A75543/Environmental-and-Personal-Information-Processor/assets/20250226_014021.jpg

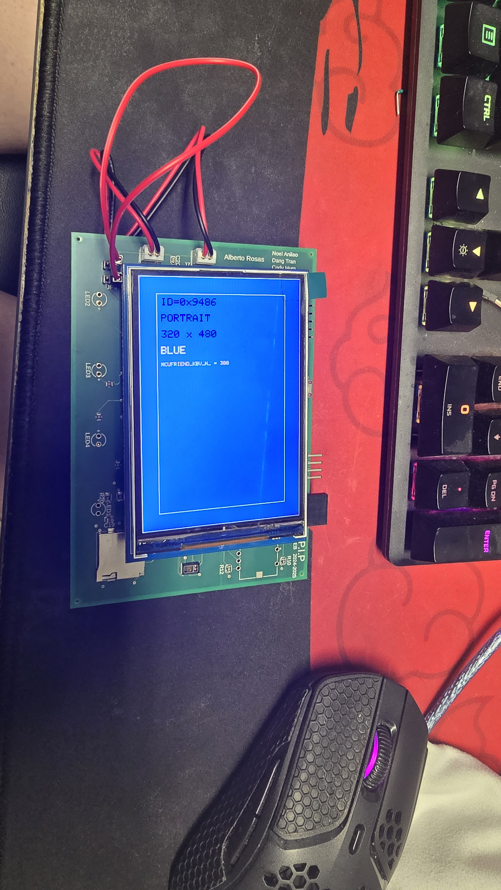
assets/20250226_014021.jpg
