A75543/Environmental-and-Personal-Information-Processor/assets/20250201_014853.jpg

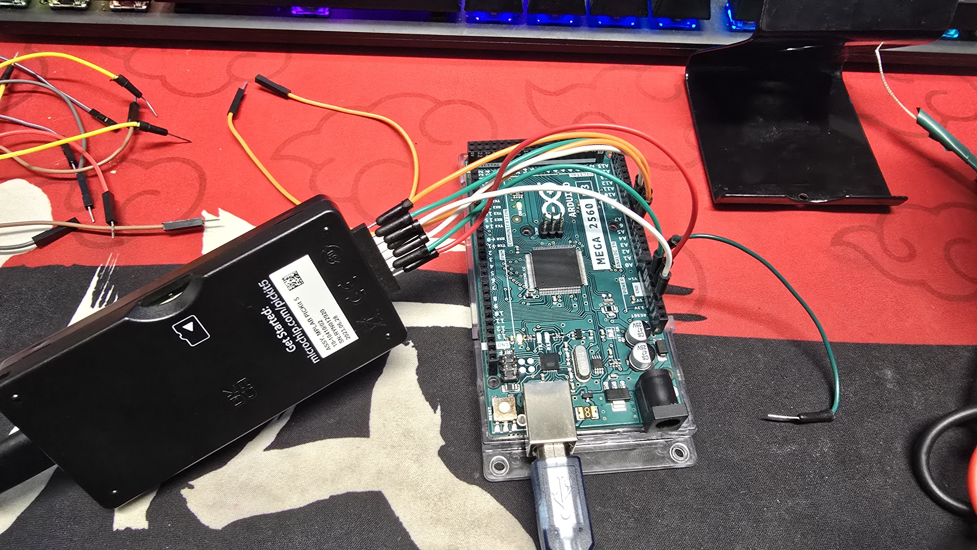
assets/20250201_014853.jpg
