A75543/Environmental-and-Personal-Information-Processor/assets/20250202_034527.jpg

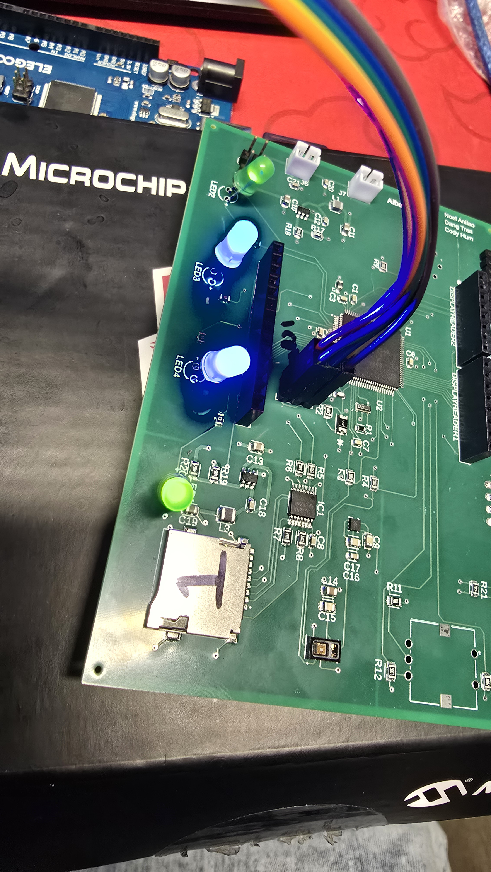
assets/20250202_034527.jpg
