A75543/Environmental-and-Personal-Information-Processor/hardware/EPIP_layout.png

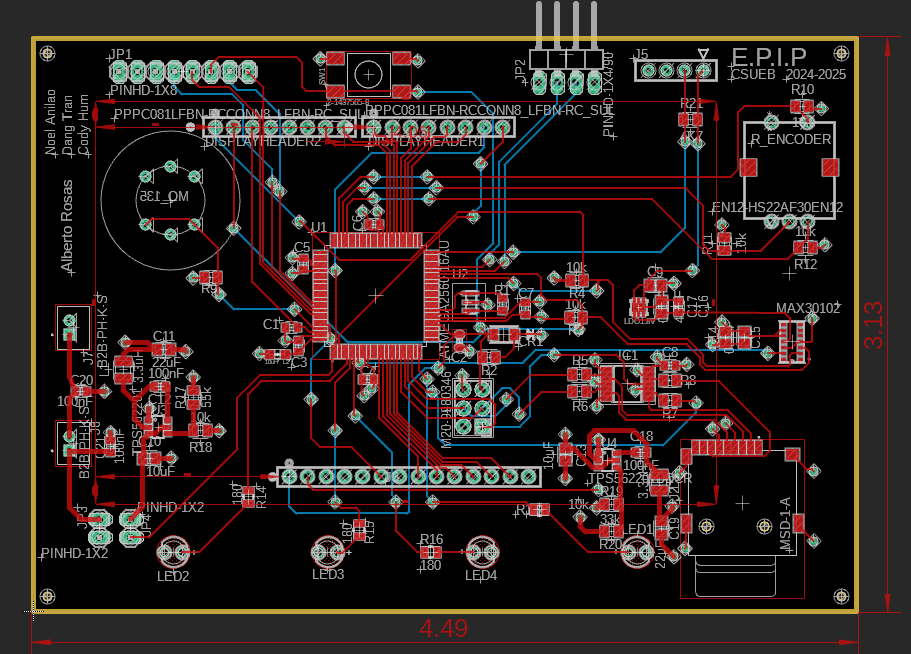
hardware/EPIP_layout.png
