A75543/Environmental-and-Personal-Information-Processor/hardware/EPIP_schem.pdf

CSTNE16M0V530000R0 ¹M | GND GND | GND
100nF | 100nF | 100nF

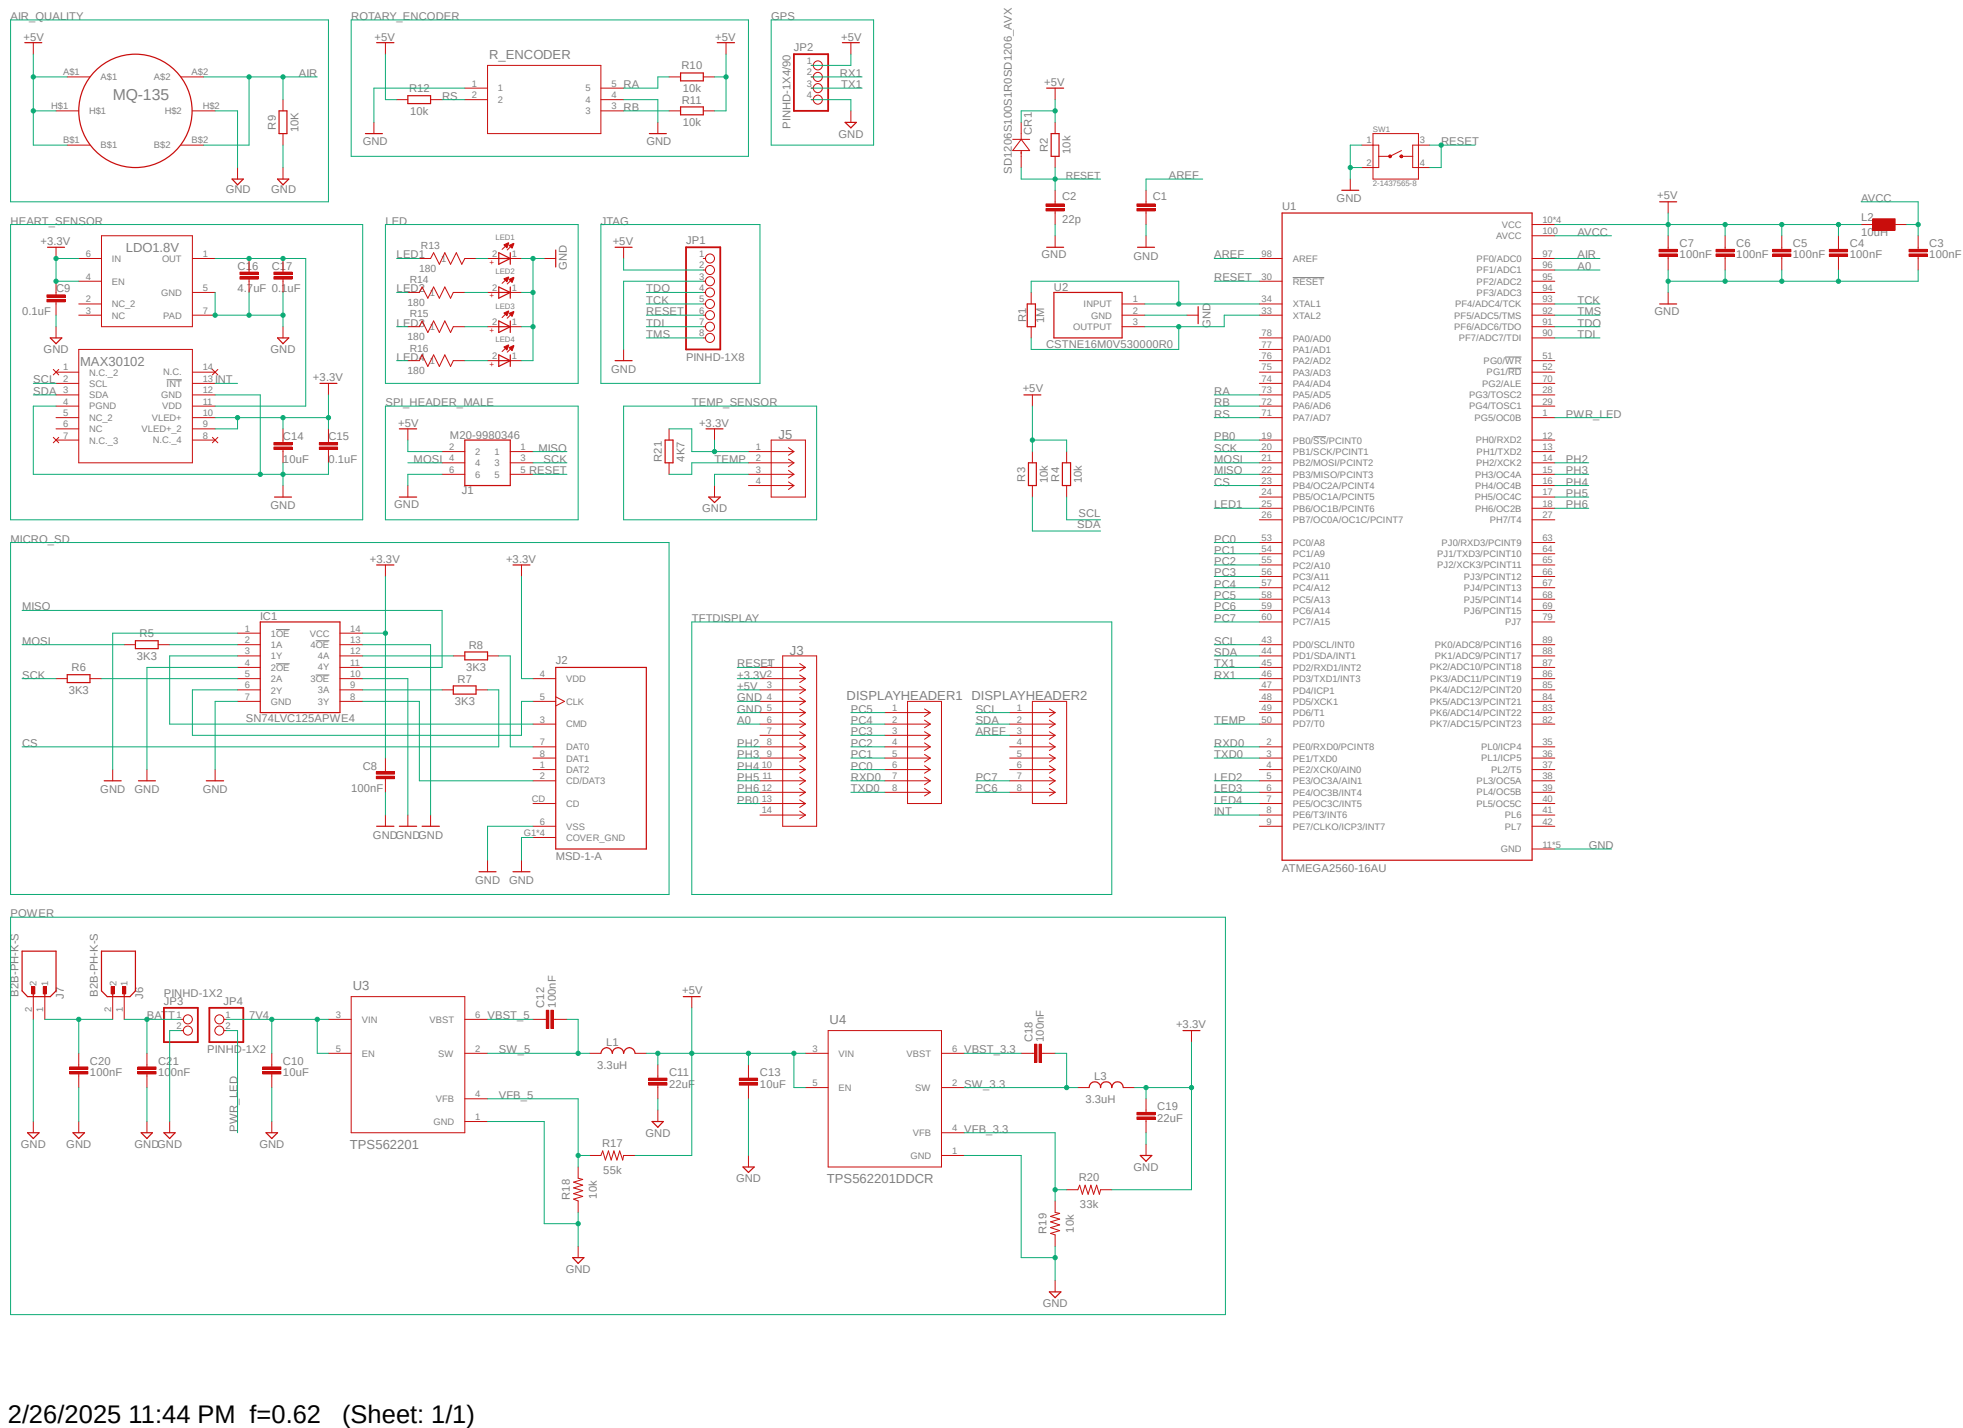
[picture p25: page 1]

2 U3 GND 1 SW 2 VIN 3 VFB 4 EN 5 VBST 6 C10 R17 R18 C11
