A75543/Environmental-and-Personal-Information-Processor/hardware/EPIP_v173.sch

## EAGLE design hardware/EPIP_v173.sch (2025-02-27, last stored version)

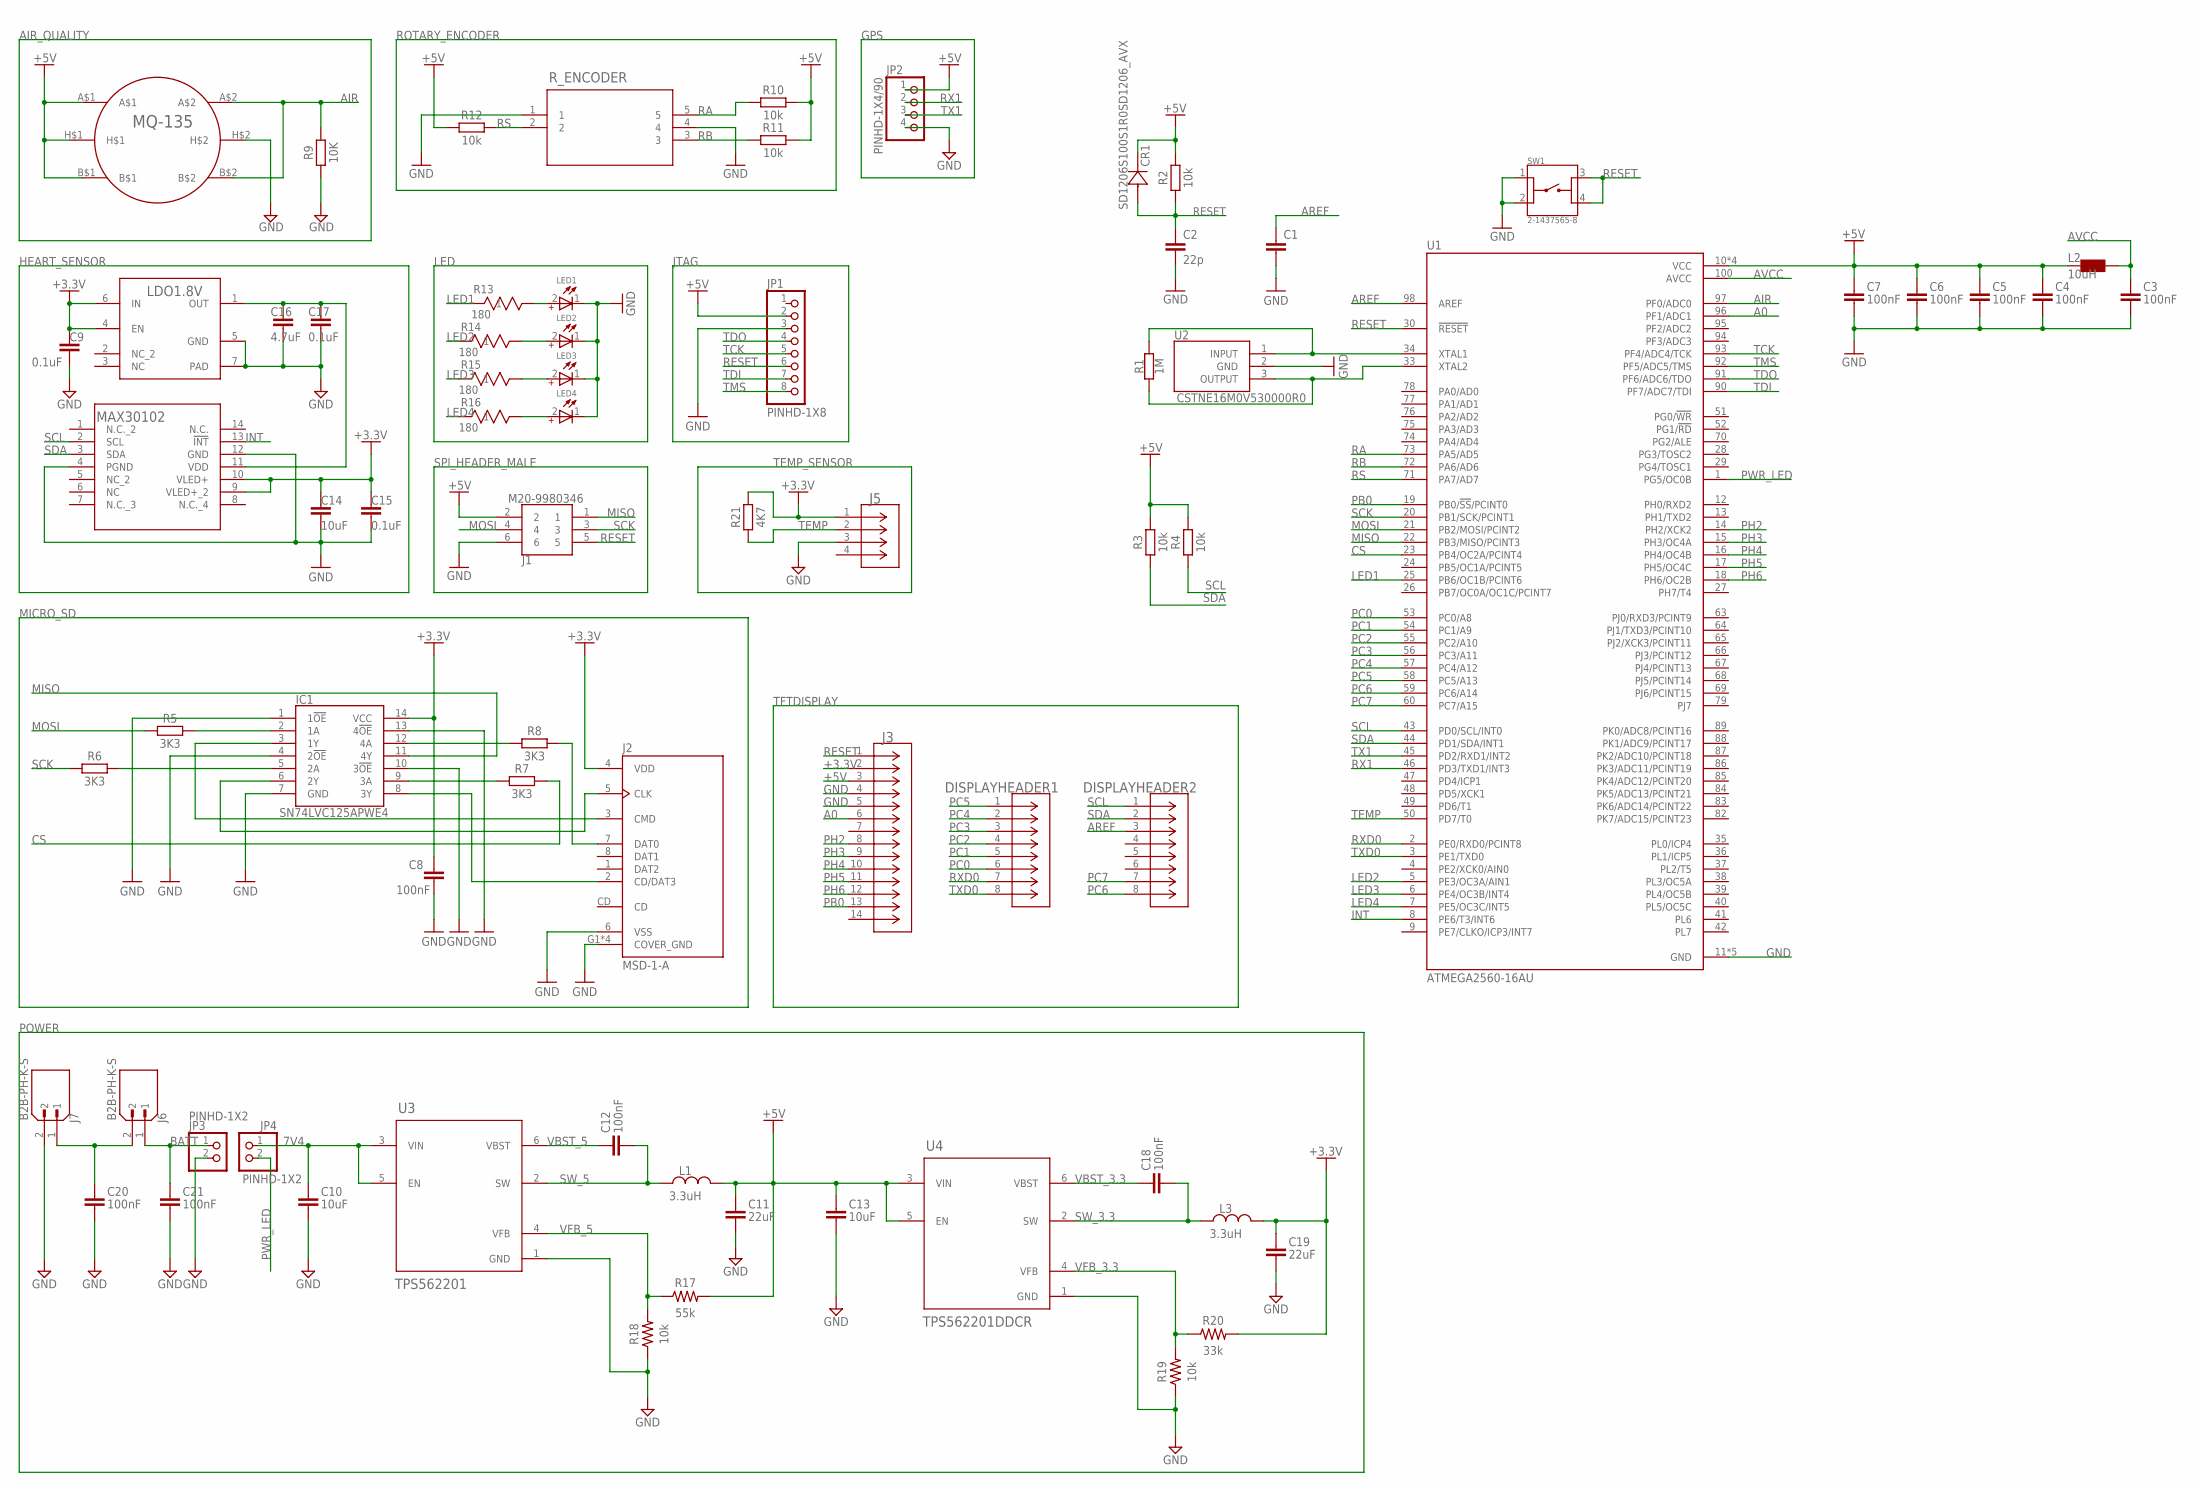
[picture p26: schematic EPIP_v173.sch]

Parts:
C1, C3, C4, C5, C6, C7, C8, C12, C18, C20, C21: 100nF; CAPC1608X85
C2: 22p; C0603-ROUND
C9, C15, C17: 0.1uF; CAPC2012X110
C10, C13, C14: 10uF; CAPC2012X110
C11, C19: 22uF; CAPC2012X110
C16: 4.7uF; CAPC1608X85
CR1: SD1206S100S1R0SD1206_AVX; SD1206_AVX
DISPLAYHEADER1, DISPLAYHEADER2: PPPC081LFBN-RCCONN8_LFBN-RC_SUL; CONN8_LFBN-RC_SUL
IC1: SN74LVC125APWE4; SOP65P640X120-14N
J1: M20-9980346; HDRV6W64P254_2X3_762X508X868P
J2: MSD-1-A; CUI_MSD-1-A
J3: PPPC141LFBN-RCCONN14_PPPN141_SUL; CONN14_PPPN141_SUL
J5: PPTC041LFBN-RCCONN_PPTC041LFBN-RC_SUL; CONN_PPTC041LFBN-RC_SUL
J6, J7: B2B-PH-K-S; JST_B2B-PH-K-S
JP1: PINHD-1X8; 1X08
JP2: PINHD-1X4/90; 1X04/90
JP3, JP4: PINHD-1X2; 1X02
L1, L3: 3.3uH; INDC2520X120N
L2: 10uH; 0805
LDO1.8V: LP5910-1.8DRVRDRV0006A_NV; DRV0006A_NV
LED1, LED2, LED3, LED4: WL-TMRW_3MM_WITHOUTSTOPPER; WL-TMRW_3MM
MAX30102: MAX30102EFD+T21-1048_F143A5+1_MXM-L; 21-1048_F143A5+1_MXM-L
R1: 1M; RESC1608X60
R2, R3, R4, R10, R11, R12, R18, R19: 10k; RESC2012X65
R5, R6, R7, R8: 3K3; RESC2012X65
R9: 10K; RESC2012X65
R13, R14, R15, R16: 180; STA_RMCF0805_STP-L
R17: 55k; RESC2012X65
R20: 33k; RESC2012X65
R21: 4K7; RESC2012X65
R_ENCODER: EN12-HS22AF30EN12; EN12-HS_TTE
SW1: 2-1437565-8; SW_SMD_2-1437565-8_4_4.50_6.00_6.00_5.00
U1: ATMEGA2560-16AU; QFP50P1600X1600X120-100N
U2: CSTNE16M0V530000R0
U3: TPS562201; DDC0006A_L
U4: TPS562201DDCR; DDC0006A_L
U$2: MQ_135_A; MQ-135

Connections:
7V4: C10.1, JP4.1, U3.3 (VIN), U3.5 (EN)
+3.3V: C8.1, C9.1, C14.1, C15.1, C19.1, IC1.14 (VCC), J2.4 (VDD), J3.2, J5.1, L3.2, LDO1.8V.4 (EN), LDO1.8V.6 (IN), MAX30102.9 (VLED+_2), MAX30102.10 (VLED+), R20.2, R21.2
+5V: C4.1, C5.1, C6.1, C7.1, C11.1, C13.1, CR1.1, J1.2, J3.3, JP1.2, JP2.1, L1.2, L2.2, R2.2, R3.2, R4.2, R10.2, R11.2, R12.1, R17.2, U1.10 (VCC), U4.3 (VIN), U4.5 (EN), U$2.A$1, U$2.B$1, U$2.H$1
A0: J3.6, U1.96 (PF1/ADC1)
AIR: R9.2, U1.97 (PF0/ADC0), U$2.A$2, U$2.B$2
AREF: C1.1, DISPLAYHEADER2.3, U1.98 (AREF)
AVCC: C3.1, L2.1, U1.100 (AVCC)
BATT: C21.1, J6.1, JP3.1
CS: R7.2, U1.23 (PB4/OC2A/PCINT4)
GND: C1.2, C2.2, C3.2, C4.2, C5.2, C6.2, C7.2, C8.2, C9.2, C10.2, C11.2, C13.2, C14.2, C15.2, C16.2, C17.2, C19.2, C20.2, C21.2, IC1.1 (1!OE), IC1.4 (2!OE), IC1.7 (GND), IC1.10 (3!OE), IC1.13 (4!OE), J1.6, J2.6 (VSS), J2.G1 (COVER_GND), J3.4, J3.5, J5.3, J7.2, JP1.3, JP2.4, JP3.2, LDO1.8V.5 (GND), LDO1.8V.7 (PAD), LED1.1 (-), LED2.1 (-), LED3.1 (-), LED4.1 (-), MAX30102.4 (PGND), MAX30102.12 (GND), R9.1, R18.1, R19.1, R_ENCODER.1, R_ENCODER.4, SW1.1, SW1.2, U1.11 (GND), U2.2 (GND), U3.1 (GND), U4.1 (GND), U$2.H$2
INT: MAX30102.13 (!INT), U1.8 (PE6/T3/INT6)
LED1: R13.1, U1.25 (PB6/OC1B/PCINT6)
LED2: R14.1, U1.5 (PE3/OC3A/AIN1)
LED3: R15.1, U1.6 (PE4/OC3B/INT4)
LED4: R16.1, U1.7 (PE5/OC3C/INT5)
MISO: IC1.11 (4Y), J1.1, U1.22 (PB3/MISO/PCINT3)
MOSI: J1.4, R5.1, U1.21 (PB2/MOSI/PCINT2)
unnamed: R1.2, U1.34 (XTAL1), U2.1 (INPUT)
unnamed: C20.1, J6.2, J7.1
unnamed: R1.1, U1.33 (XTAL2), U2.3 (OUTPUT)
unnamed: IC1.2 (1A), R5.2
unnamed: IC1.3 (1Y), J2.3 (CMD)
unnamed: IC1.9 (3A), R7.1
unnamed: IC1.5 (2A), R6.2
unnamed: IC1.6 (2Y), J2.5 (CLK)
unnamed: IC1.8 (3Y), J2.2 (CD/DAT3)
unnamed: IC1.12 (4A), R8.1
unnamed: J2.7 (DAT0), R8.2
unnamed: LED1.2 (+), R13.2
unnamed: LED2.2 (+), R14.2
unnamed: LED3.2 (+), R15.2
unnamed: LED4.2 (+), R16.2
PB0: J3.13, U1.19 (PB0/!SS!/PCINT0)
PC0: DISPLAYHEADER1.6, U1.53 (PC0/A8)
PC1: DISPLAYHEADER1.5, U1.54 (PC1/A9)
PC2: DISPLAYHEADER1.4, U1.55 (PC2/A10)
PC3: DISPLAYHEADER1.3, U1.56 (PC3/A11)
PC4: DISPLAYHEADER1.2, U1.57 (PC4/A12)
PC5: DISPLAYHEADER1.1, U1.58 (PC5/A13)
PC6: DISPLAYHEADER2.8, U1.59 (PC6/A14)
PC7: DISPLAYHEADER2.7, U1.60 (PC7/A15)
PH2: J3.8, U1.14 (PH2/XCK2)
PH3: J3.9, U1.15 (PH3/OC4A)
PH4: J3.10, U1.16 (PH4/OC4B)
PH5: J3.11, U1.17 (PH5/OC4C)
PH6: J3.12, U1.18 (PH6/OC2B)
PWR_LED: JP4.2, U1.1 (PG5/OC0B)
RA: R10.1, R_ENCODER.5, U1.73 (PA5/AD5)
RB: R11.1, R_ENCODER.3, U1.72 (PA6/AD6)
RESET: C2.1, CR1.2, J1.5, J3.1, JP1.6, R2.1, SW1.3, SW1.4, U1.30 (!RESET)
RS: R12.2, R_ENCODER.2, U1.71 (PA7/AD7)
RX1: JP2.2, U1.46 (PD3/TXD1/INT3)
RXD0: DISPLAYHEADER1.7, U1.2 (PE0/RXD0/PCINT8)
SCK: J1.3, R6.1, U1.20 (PB1/SCK/PCINT1)
SCL: DISPLAYHEADER2.1, MAX30102.2 (SCL), R4.1, U1.43 (PD0/SCL/INT0)
SDA: DISPLAYHEADER2.2, MAX30102.3 (SDA), R3.1, U1.44 (PD1/SDA/INT1)
SW_3.3: C18.2, L3.1, U4.2 (SW)
SW_5: C12.2, L1.1, U3.2 (SW)
TCK: JP1.5, U1.93 (PF4/ADC4/TCK)
TDI: JP1.7, U1.90 (PF7/ADC7/TDI)
TDO: JP1.4, U1.91 (PF6/ADC6/TDO)
TEMP: J5.2, R21.1, U1.50 (PD7/T0)
TMS: JP1.8, U1.92 (PF5/ADC5/TMS)
TX1: JP2.3, U1.45 (PD2/RXD1/INT2)
TXD0: DISPLAYHEADER1.8, U1.3 (PE1/TXD0)
VBST_3.3: C18.1, U4.6 (VBST)
VBST_5: C12.1, U3.6 (VBST)
VDD: C16.1, C17.1, LDO1.8V.1 (OUT), MAX30102.11 (VDD)
VFB_3.3: R19.2, R20.1, U4.4 (VFB)
VFB_5: R17.1, R18.2, U3.4 (VFB)
