A75543/Environmental-and-Personal-Information-Processor/(notices)

Notices in the files:
parts and their libraries:
Switching Diode: COPYRIGHT: Copyright (C) 2024 Ultra Librarian. All rights reserved.
