A75543/Environmental-and-Personal-Information-Processor/assets/20250211_004202.jpg

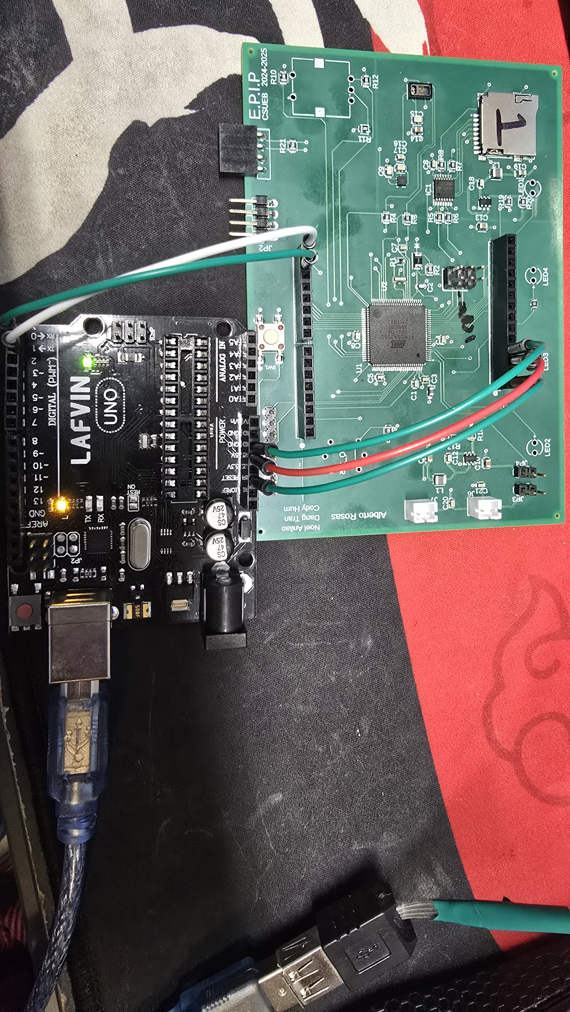
assets/20250211_004202.jpg
